lilith-project/lilith-hw-design/Proof of concept/Manufacturing/Lilith-POC_BOM.xls

Sheet: Appro
Item | Reference | Part Name | Value | Color | Qty | Category | Supplier | Supplier Reference | Qty per unit | Unit Price (for a batch of 2) | Unit Price (for a batch of 100) | Price per board (for a batch of 2) | Price per board (for a batch of 100)
68 | S1 | SW-SMD-SMALL |  |  | 1 | JTAG/RS232 Debug | Digikey | 1.14002.0030000CT-ND |  | 3.25 | 2.5982 | 3.25 | 2.5982
1 | U8-9 | 74LVC1G125DCK |  |  | 2 | JTAG/RS232 Debug | Digikey | 296-11604-1-ND |  | 0.08 | 0.0378 | 0.16 | 0.0756
56 | R4 R22 | RES0603,1k5 | 1k5 |  | 2 | JTAG/RS232 Debug | Digikey | 311-1.5KGRCT-ND |  | 0.01 | 0.0048 | 0.02 | 0.0096
50 | R30 | RES0603,100k | 100k |  | 1 | CPU | Digikey | 311-100KGRCT-ND |  | 0.01 | 0.0048 | 0.01 | 0.0048
14 | C28 C49 C51 C27 C72 | CAP0402,100pF | 100pF |  | 5 | Arduino | Digikey | 311-1024-1-ND |  | 0.0059 | 0.0027 | 0.0295 | 0.0135
13 | C1-26 C65 | CAP0402,100pF | 100pF |  | 27 | CPU | Digikey | 311-1024-1-ND |  | 0.0059 | 0.0027 | 0.1593 | 0.0729
16 | C42-48 C73 | CAP0402,100pF | 100pF |  | 8 | Ethernet | Digikey | 311-1024-1-ND |  | 0.0059 | 0.0027 | 0.0472 | 0.0216
21 | C66 | CAP0402,100pF | 100pF |  | 1 | Ext Power Supply +5V | Digikey | 311-1024-1-ND |  | 0.0059 | 0.0027 | 0.0059 | 0.0027
18 | C54-62 C52-53 | CAP0402,100pF | 100pF |  | 11 | JTAG/RS232 Debug | Digikey | 311-1024-1-ND |  | 0.0059 | 0.0027 | 0.0649 | 0.0297
20 | C70 | CAP0402,100pF | 100pF |  | 1 | Power supply +1V8 | Digikey | 311-1024-1-ND |  | 0.0059 | 0.0027 | 0.0059 | 0.0027
19 | C68 | CAP0402,100pF | 100pF |  | 1 | Power supply +3V3 | Digikey | 311-1024-1-ND |  | 0.0059 | 0.0027 | 0.0059 | 0.0027
22 | C29 | CAP0402,100pF | 100pF |  | 1 | SD Card | Digikey | 311-1024-1-ND |  | 0.0059 | 0.0027 | 0.0059 | 0.0027
15 | C34-36 | CAP0402,100pF | 100pF |  | 3 | USB Device | Digikey | 311-1024-1-ND |  | 0.0059 | 0.0027 | 0.0177 | 0.0081
17 | C30-32 | CAP0402,100pF | 100pF |  | 3 | USB Host | Digikey | 311-1024-1-ND |  | 0.0059 | 0.0027 | 0.0177 | 0.0081
54 | R26-29 R24-25 R33-34 | RES0603,10k | 10k |  | 8 | CPU | Digikey | 311-10KGRCT-ND |  | 0.01 | 0.0027 | 0.08 | 0.0216
52 | R17 R19-21 | RES0603,10k | 10k |  | 4 | Ethernet | Digikey | 311-10KGRCT-ND |  | 0.01 | 0.0027 | 0.04 | 0.0108
53 | R23 R31-32 | RES0603,10k | 10k |  | 3 | JTAG/RS232 Debug | Digikey | 311-10KGRCT-ND |  | 0.01 | 0.0027 | 0.03 | 0.0081
51 | R5 | RES0603,10k | 10k |  | 1 | SD Card | Digikey | 311-10KGRCT-ND |  | 0.01 | 0.0027 | 0.01 | 0.0027
25 | C64 | CAP0603,1nF | 1nF |  | 1 | CPU | Digikey | 311-1342-1-ND |  | 0.034 | 0.0158 | 0.034 | 0.0158
55 | R10 | RES0603,15k | 15k |  | 1 | USB Device | Digikey | 311-15KGRCT-ND |  | 0.01 | 0.0048 | 0.01 | 0.0048
58 | R36-37 | RES0603,220R | 220R |  | 2 | Arduino | Digikey | 311-220GRCT-ND |  | 0.01 | 0.0048 | 0.02 | 0.0096
57 | R18 | RES0603,220R | 220R |  | 1 | Ethernet | Digikey | 311-220GRCT-ND |  | 0.01 | 0.0048 | 0.01 | 0.0048
59 | R11 | RES0603,22k | 22k |  | 1 | USB Device | Digikey | 311-22KGRCT-ND |  | 0.01 | 0.0048 | 0.01 | 0.0048
60 | R1-2 | RES0603,27R | 27R |  | 2 | JTAG/RS232 Debug | Digikey | 311-27GRCT-ND |  | 0.01 | 0.0048 | 0.02 | 0.0096
62 | R8-9 | RES0603,39R | 39R |  | 2 | USB Device | Digikey | 311-39GRCT-ND |  | 0.01 | 0.0048 | 0.02 | 0.0096
61 | R6-7 | RES0603,39R | 39R |  | 2 | USB Host | Digikey | 311-39GRCT-ND |  | 0.01 | 0.0048 | 0.02 | 0.0096
64 | R35 | RES0603,470R | 470R |  | 1 | Ext Power Supply +5V | Digikey | 311-470GRCT-ND |  | 0.01 | 0.0048 | 0.01 | 0.0048
63 | R3 | RES0603,470R | 470R |  | 1 | JTAG/RS232 Debug | Digikey | 311-470GRCT-ND |  | 0.01 | 0.0048 | 0.01 | 0.0048
65 | R12-15 | RES0603,49R9 | 49R9 |  | 4 | Ethernet | Digikey | 311-49.9HRCT-ND |  | 0.014 | 0.0063 | 0.056 | 0.0252
66 | R16 | RES0603,6k49 | 6k49 |  | 1 | Ethernet | Digikey | 311-6.49KHRCT-ND |  | 0.014 | 0.0063 | 0.014 | 0.0063
41 | D2 | LED0603 |  | Green | 1 | Ethernet | Digikey | 475-1409-1-ND |  | 0.1 | 0.068 | 0.1 | 0.068
40 | D1 | LED0603 |  | Green | 1 | Ext Power Supply +5V | Digikey | 475-1409-1-ND |  | 0.1 | 0.068 | 0.1 | 0.068
42 | D3 | LED0603 |  | Red | 1 | Arduino | Digikey | 475-2512-1-ND |  | 0.11 | 0.0716 | 0.11 | 0.0716
43 | D4 | LED0603 |  | Yellow | 1 | Arduino | Digikey | 475-2558-1-ND |  | 0.11 | 0.0742 | 0.11 | 0.0742
24 | C63 | CAP0603,10nF | 10nF |  | 1 | CPU | Digikey | 478-1227-1-ND |  | 0.019 | 0.0088 | 0.019 | 0.0088
23 | C33 C37-38 | CAP0603,100nF | 100nF |  | 3 | Ethernet | Digikey | 478-1239-1-ND |  | 0.02 | 0.00764 | 0.06 | 0.02292
26 | C39-41 C50 | CAP-POL-1206,10uF | 10uF |  | 4 | Ethernet | Digikey | 493-2351-1-ND |  | 0.349 | 0.1344 | 1.396 | 0.5376
27 | C67 | CAP-POL-1206,10uF | 10uF |  | 1 | Ext Power Supply +5V | Digikey | 493-2351-1-ND |  | 0.349 | 0.1344 | 0.349 | 0.1344
29 | C71 | CAP-POL-1206,10uF | 10uF |  | 1 | Power supply +1V8 | Digikey | 493-2351-1-ND |  | 0.349 | 0.1344 | 0.349 | 0.1344
28 | C69 | CAP-POL-1206,10uF | 10uF |  | 1 | Power supply +3V3 | Digikey | 493-2351-1-ND |  | 0.349 | 0.1344 | 0.349 | 0.1344
38 | U11 | LD1117-3.3-SOT223 |  |  | 1 | Power supply +3V3 | Digikey | 497-1241-1-ND |  | 0.48 | 0.3059 | 0.48 | 0.3059
39 | U10 | LD1117-5-SOT223 |  |  | 1 | Ext Power Supply +5V | Digikey | 497-1243-1-ND |  | 0.48 | 0.3059 | 0.48 | 0.3059
37 | U12 | LD1117-1.8-SOT223 |  |  | 1 | Power supply +1V8 | Digikey | 497-7308-1-ND |  | 0.48 | 0.3059 | 0.48 | 0.3059
33 | F1 | FUSE-PTC-RESETTABLE,500 mA | 500 mA |  | 1 | USB Host | Digikey | 507-1489-1-ND |  | 0.28 | 0.1785 | 0.28 | 0.1785
49 | Y2 | OSC,6MHz | 6MHz |  | 1 | JTAG/RS232 Debug | Digikey | 535-11003-1-ND |  | 2.81 | 1.6875 | 2.81 | 1.6875
48 | Y1 | OSC,50MHz | 50MHz |  | 1 | Ethernet | Digikey | 535-11779-1-ND |  | 1.76 | 1.0575 | 1.76 | 1.0575
47 | Y3 | OSC,18.432MHz | 18.432MHz |  | 1 | CPU | Digikey | 535-9660-5-ND |  | 2.08 | 1.19 | 2.08 | 1.19
46 | U2 | MT48LC16M16A2 |  |  | 1 | CPU | Digikey | 557-1289-1-ND |  | 10.45 | 8.1864 | 10.45 | 8.1864
36 | U5 | KS8721_12 |  |  | 1 | Ethernet | Digikey | 576-2971-5-ND |  | 4.75 | 2.954 | 4.75 | 2.954
30 | L2-3 | FERRITE-0603,180R | 180R |  | 2 | Ethernet | Digikey | 587-1881-1-ND |  | 0.31 | 0.088 | 0.62 | 0.176
31 | L4 | FERRITE-0603,180R | 180R |  | 1 | JTAG/RS232 Debug | Digikey | 587-1881-1-ND |  | 0.31 | 0.088 | 0.31 | 0.088
32 | U4 | FT2232D |  |  | 1 | JTAG/RS232 Debug | Digikey | 768-1010-1-ND |  | 6.99 | 5.17 | 6.99 | 5.17
2 | U7 | 93C46B |  |  | 1 | JTAG/RS232 Debug | Digikey | 93C46BT-I/OTCT-ND |  | 0.32 | 0.19 | 0.32 | 0.19
12 | U1 | AT91SAM9XE128 |  |  | 1 | CPU | Digikey | AT91SAM9XE128-QU-ND |  | 19.87 | 11.088 | 19.87 | 11.088
35 | J8 | JACK_2.1MM |  |  | 1 | Ext Power Supply +5V | Digikey | CP-102A-ND |  | 0.92 | 0.4324 | 0.92 | 0.4324
9 | J6 | ARDUINO_XIOH |  |  | 1 | Arduino | Digikey | ED10529-ND | 2.5 | 0.45 | 0.322 | 0.18 | 0.1288
10 | J7 | ARDUINO_XIOL |  |  | 1 | Arduino | Digikey | ED10529-ND | 2.5 | 0.45 | 0.322 | 0.18 | 0.1288
11 | J15 | ARDUINO_XIO_POWER |  |  | 1 | Arduino | Digikey | ED10529-ND | 10 | 0.45 | 0.322 | 0.045 | 0.0322
70 | J10 | USBB |  |  | 1 | USB Device | Digikey | ED2983-ND |  | 0.54 | 0.34 | 0.54 | 0.34
69 | J9 | USBA |  |  | 1 | USB Host | Digikey | ED2989-ND |  | 0.45 | 0.28 | 0.45 | 0.28
71 | J12 | USBB-MINI |  |  | 1 | JTAG/RS232 Debug | Digikey | ED2992CT-ND |  | 0.68 | 0.546 | 0.68 | 0.546
45 | J13 | MICROSD |  |  | 1 | SD Card | Digikey | HR1972CT-ND |  | 1.79 | 1.1 | 1.79 | 1.1
44 | U3 U6 | MCP3008 |  |  | 2 | Arduino | Digikey | MAX11602EEE+-ND |  | 3.52 | 1.887 | 7.04 | 3.774
3 | J5 | ARDUINO_ADCH |  |  | 1 | Arduino | Digikey | S1012EC-40-ND | 5 | 0.51 | 0.378 | 0.102 | 0.0756
4 | J4 | ARDUINO_ADCL |  |  | 1 | Arduino | Digikey | S1012EC-40-ND | 5 | 0.51 | 0.378 | 0.102 | 0.0756
5 | J3 | ARDUINO_COM |  |  | 1 | Arduino | Digikey | S1012EC-40-ND | 5 | 0.51 | 0.378 | 0.102 | 0.0756
6 | J14 | ARDUINO_POWER |  |  | 1 | Arduino | Digikey | S1012EC-40-ND | 6.666666667 | 0.51 | 0.378 | 0.0765 | 0.0567
7 | J1 | ARDUINO_PWMH |  |  | 1 | Arduino | Digikey | S1012EC-40-ND | 5 | 0.51 | 0.378 | 0.102 | 0.0756
8 | J2 | ARDUINO_PWML |  |  | 1 | Arduino | Digikey | S1012EC-40-ND | 5 | 0.51 | 0.378 | 0.102 | 0.0756
67 | J11 | RJ45-MAGNETIC |  |  | 1 | Ethernet | Digikey | S9399-ND |  | 2.89 | 1.8887 | 2.89 | 1.8887
34 | X1-4 | HOLE-3MM |  |  | 4 |  |  |  |  |  |  | 0 | 0
 |  |  |  |  |  |  |  |  |  | Price per board (for a batch of 100) |  |  | 46.22932
 |  |  |  |  |  |  |  |  |  | Price per board (for a batch of 2) |  | 74.1174

Sheet: Assembly
Reference | Part Name | Value | Color | Supplier Reference
U8 | 74LVC1G125DCK |  |  | 296-11604-1-ND
U9 | 74LVC1G125DCK |  |  | 296-11604-1-ND
U7 | 93C46B |  |  | 93C46BT-I/OTCT-ND
J5 | ARDUINO_ADCH |  |  | S1012EC-40-ND
J4 | ARDUINO_ADCL |  |  | S1012EC-40-ND
J3 | ARDUINO_COM |  |  | S1012EC-40-ND
J14 | ARDUINO_POWER |  |  | S1012EC-40-ND
J1 | ARDUINO_PWMH |  |  | S1012EC-40-ND
J2 | ARDUINO_PWML |  |  | S1012EC-40-ND
J6 | ARDUINO_XIOH |  |  | ED10529-ND
J7 | ARDUINO_XIOL |  |  | ED10529-ND
J15 | ARDUINO_XIO_POWER |  |  | ED10529-ND
U1 | AT91SAM9XE128 |  |  | AT91SAM9XE128-QU-ND
C1 | CAP0402,100pF | 100pF |  | 311-1024-1-ND
C2 | CAP0402,100pF | 100pF |  | 311-1024-1-ND
C3 | CAP0402,100pF | 100pF |  | 311-1024-1-ND
C4 | CAP0402,100pF | 100pF |  | 311-1024-1-ND
C5 | CAP0402,100pF | 100pF |  | 311-1024-1-ND
C6 | CAP0402,100pF | 100pF |  | 311-1024-1-ND
C7 | CAP0402,100pF | 100pF |  | 311-1024-1-ND
C8 | CAP0402,100pF | 100pF |  | 311-1024-1-ND
C9 | CAP0402,100pF | 100pF |  | 311-1024-1-ND
C10 | CAP0402,100pF | 100pF |  | 311-1024-1-ND
C11 | CAP0402,100pF | 100pF |  | 311-1024-1-ND
C12 | CAP0402,100pF | 100pF |  | 311-1024-1-ND
C13 | CAP0402,100pF | 100pF |  | 311-1024-1-ND
C14 | CAP0402,100pF | 100pF |  | 311-1024-1-ND
C15 | CAP0402,100pF | 100pF |  | 311-1024-1-ND
C16 | CAP0402,100pF | 100pF |  | 311-1024-1-ND
C17 | CAP0402,100pF | 100pF |  | 311-1024-1-ND
C18 | CAP0402,100pF | 100pF |  | 311-1024-1-ND
C19 | CAP0402,100pF | 100pF |  | 311-1024-1-ND
C20 | CAP0402,100pF | 100pF |  | 311-1024-1-ND
C21 | CAP0402,100pF | 100pF |  | 311-1024-1-ND
C22 | CAP0402,100pF | 100pF |  | 311-1024-1-ND
C23 | CAP0402,100pF | 100pF |  | 311-1024-1-ND
C24 | CAP0402,100pF | 100pF |  | 311-1024-1-ND
C25 | CAP0402,100pF | 100pF |  | 311-1024-1-ND
C26 | CAP0402,100pF | 100pF |  | 311-1024-1-ND
C27 | CAP0402,100pF | 100pF |  | 311-1024-1-ND
C28 | CAP0402,100pF | 100pF |  | 311-1024-1-ND
C29 | CAP0402,100pF | 100pF |  | 311-1024-1-ND
C30 | CAP0402,100pF | 100pF |  | 311-1024-1-ND
C31 | CAP0402,100pF | 100pF |  | 311-1024-1-ND
C32 | CAP0402,100pF | 100pF |  | 311-1024-1-ND
C34 | CAP0402,100pF | 100pF |  | 311-1024-1-ND
C35 | CAP0402,100pF | 100pF |  | 311-1024-1-ND
C36 | CAP0402,100pF | 100pF |  | 311-1024-1-ND
C42 | CAP0402,100pF | 100pF |  | 311-1024-1-ND
C43 | CAP0402,100pF | 100pF |  | 311-1024-1-ND
C44 | CAP0402,100pF | 100pF |  | 311-1024-1-ND
C45 | CAP0402,100pF | 100pF |  | 311-1024-1-ND
C46 | CAP0402,100pF | 100pF |  | 311-1024-1-ND
C47 | CAP0402,100pF | 100pF |  | 311-1024-1-ND
C48 | CAP0402,100pF | 100pF |  | 311-1024-1-ND
C49 | CAP0402,100pF | 100pF |  | 311-1024-1-ND
C51 | CAP0402,100pF | 100pF |  | 311-1024-1-ND
C52 | CAP0402,100pF | 100pF |  | 311-1024-1-ND
C53 | CAP0402,100pF | 100pF |  | 311-1024-1-ND
C54 | CAP0402,100pF | 100pF |  | 311-1024-1-ND
C55 | CAP0402,100pF | 100pF |  | 311-1024-1-ND
C56 | CAP0402,100pF | 100pF |  | 311-1024-1-ND
C57 | CAP0402,100pF | 100pF |  | 311-1024-1-ND
C58 | CAP0402,100pF | 100pF |  | 311-1024-1-ND
C59 | CAP0402,100pF | 100pF |  | 311-1024-1-ND
C60 | CAP0402,100pF | 100pF |  | 311-1024-1-ND
C61 | CAP0402,100pF | 100pF |  | 311-1024-1-ND
C62 | CAP0402,100pF | 100pF |  | 311-1024-1-ND
C65 | CAP0402,100pF | 100pF |  | 311-1024-1-ND
C66 | CAP0402,100pF | 100pF |  | 311-1024-1-ND
C68 | CAP0402,100pF | 100pF |  | 311-1024-1-ND
C70 | CAP0402,100pF | 100pF |  | 311-1024-1-ND
C72 | CAP0402,100pF | 100pF |  | 311-1024-1-ND
C73 | CAP0402,100pF | 100pF |  | 311-1024-1-ND
C74 | CAP0402,100pF | 100pF |  | 311-1024-1-ND
C33 | CAP0603,100nF | 100nF |  | 478-1239-1-ND
C37 | CAP0603,100nF | 100nF |  | 478-1239-1-ND
C38 | CAP0603,100nF | 100nF |  | 478-1239-1-ND
C63 | CAP0603,10nF | 10nF |  | 478-1227-1-ND
C64 | CAP0603,1nF | 1nF |  | 311-1342-1-ND
C39 | CAP-POL-1206,10uF | 10uF |  | 493-2351-1-ND
C40 | CAP-POL-1206,10uF | 10uF |  | 493-2351-1-ND
C41 | CAP-POL-1206,10uF | 10uF |  | 493-2351-1-ND
C50 | CAP-POL-1206,10uF | 10uF |  | 493-2351-1-ND
C67 | CAP-POL-1206,10uF | 10uF |  | 493-2351-1-ND
C69 | CAP-POL-1206,10uF | 10uF |  | 493-2351-1-ND
C71 | CAP-POL-1206,10uF | 10uF |  | 493-2351-1-ND
L2 | FERRITE-0603,180R | 180R |  | 587-1881-1-ND
L3 | FERRITE-0603,180R | 180R |  | 587-1881-1-ND
L4 | FERRITE-0603,180R | 180R |  | 587-1881-1-ND
U4 | FT2232D |  |  | 768-1010-1-ND
F1 | FUSE-PTC-RESETTABLE,500 mA | 500 mA |  | 507-1489-1-ND
X1 | HOLE-3MM
X2 | HOLE-3MM
X3 | HOLE-3MM
X4 | HOLE-3MM
J8 | JACK_2.1MM |  |  | CP-102A-ND
U5 | KS8721_12 |  |  | 576-2971-5-ND
U12 | LD1117-1.8-SOT223 |  |  | 497-7308-1-ND
U11 | LD1117-3.3-SOT223 |  |  | 497-1241-1-ND
U10 | LD1117-5-SOT223 |  |  | 497-1243-1-ND
D1 | LED0603 |  | Green | 475-1409-1-ND
D2 | LED0603 |  | Green | 475-1409-1-ND
D3 | LED0603 |  | Red | 475-2512-1-ND
D4 | LED0603 |  | Yellow | 475-2558-1-ND
U3 | MCP3008 |  |  | MAX11602EEE+-ND
U6 | MCP3008 |  |  | MAX11602EEE+-ND
J13 | MICROSD |  |  | HR1972CT-ND
U2 | MT48LC16M16A2 |  |  | 557-1289-1-ND
Y3 | OSC,18.432MHz | 18.432MHz |  | 535-9660-5-ND
Y1 | OSC,50MHz | 50MHz |  | 535-11779-1-ND
Y2 | OSC,6MHz | 6MHz |  | 535-11003-1-ND
R30 | RES0603,100k | 100k |  | 311-100KGRCT-ND
R5 | RES0603,10k | 10k |  | 311-10KGRCT-ND
R17 | RES0603,10k | 10k |  | 311-10KGRCT-ND
R19 | RES0603,10k | 10k |  | 311-10KGRCT-ND
R20 | RES0603,10k | 10k |  | 311-10KGRCT-ND
R21 | RES0603,10k | 10k |  | 311-10KGRCT-ND
R23 | RES0603,10k | 10k |  | 311-10KGRCT-ND
R24 | RES0603,10k | 10k |  | 311-10KGRCT-ND
R25 | RES0603,10k | 10k |  | 311-10KGRCT-ND
R26 | RES0603,10k | 10k |  | 311-10KGRCT-ND
R27 | RES0603,10k | 10k |  | 311-10KGRCT-ND
R28 | RES0603,10k | 10k |  | 311-10KGRCT-ND
R29 | RES0603,10k | 10k |  | 311-10KGRCT-ND
R31 | RES0603,10k | 10k |  | 311-10KGRCT-ND
R32 | RES0603,10k | 10k |  | 311-10KGRCT-ND
R33 | RES0603,10k | 10k |  | 311-10KGRCT-ND
R34 | RES0603,10k | 10k |  | 311-10KGRCT-ND
R10 | RES0603,15k | 15k |  | 311-15KGRCT-ND
R4 | RES0603,1k5 | 1k5 |  | 311-1.5KGRCT-ND
R22 | RES0603,1k5 | 1k5 |  | 311-1.5KGRCT-ND
R18 | RES0603,220R | 220R |  | 311-220GRCT-ND
R36 | RES0603,220R | 220R |  | 311-220GRCT-ND
R37 | RES0603,220R | 220R |  | 311-220GRCT-ND
R11 | RES0603,22k | 22k |  | 311-22KGRCT-ND
R1 | RES0603,27R | 27R |  | 311-27GRCT-ND
R2 | RES0603,27R | 27R |  | 311-27GRCT-ND
R6 | RES0603,39R | 39R |  | 311-39GRCT-ND
R7 | RES0603,39R | 39R |  | 311-39GRCT-ND
R8 | RES0603,39R | 39R |  | 311-39GRCT-ND
R9 | RES0603,39R | 39R |  | 311-39GRCT-ND
R3 | RES0603,470R | 470R |  | 311-470GRCT-ND
R35 | RES0603,470R | 470R |  | 311-470GRCT-ND
R12 | RES0603,49R9 | 49R9 |  | 311-49.9HRCT-ND
R13 | RES0603,49R9 | 49R9 |  | 311-49.9HRCT-ND
R14 | RES0603,49R9 | 49R9 |  | 311-49.9HRCT-ND
R15 | RES0603,49R9 | 49R9 |  | 311-49.9HRCT-ND
R16 | RES0603,6k49 | 6k49 |  | 311-6.49KHRCT-ND
J11 | RJ45-MAGNETIC |  |  | S9399-ND
S1 | SW-SMD-SMALL |  |  | 1.14002.0030000CT-ND
J9 | USBA |  |  | ED2989-ND
J10 | USBB |  |  | ED2983-ND
J12 | USBB-MINI |  |  | ED2992CT-ND

Sheet: 2012-04-22-Lilit-rev1A
Index | Quantity | Part Number | Description | Customer Reference | Backorder Quantity | Unit Price USD | Extended Price USD
1 | 2 | 1.14002.0030000CT-ND | SWITCH PUSH SPST-NO 0.1A 35V |  | 0 | 3.25 | $6.50
2 | 10 | 311-1.5KGRCT-ND | RES 1.5K OHM 1/10W 5% 0603 SMD |  | 0 | 0.01 | $0.10
3 | 10 | 311-100KGRCT-ND | RES 100K OHM 1/10W 5% 0603 SMD |  | 0 | 0.01 | $0.10
4 | 140 | 311-1024-1-ND | CAP CER 100PF 50V 5% NPO 0402 |  | 0 | 0.0059 | $0.83
5 | 40 | 311-10KGRCT-ND | RES 10K OHM 1/10W 5% 0603 SMD |  | 0 | 0.01 | $0.40
6 | 10 | 311-1342-1-ND | CAP CER 1000PF 25V 5% NPO 0603 |  | 0 | 0.034 | $0.34
7 | 10 | 311-15KGRCT-ND | RES 15K OHM 1/10W 5% 0603 SMD |  | 0 | 0.01 | $0.10
8 | 10 | 311-220GRCT-ND | RES 220 OHM 1/10W 5% 0603 SMD |  | 0 | 0.01 | $0.10
9 | 10 | 311-22KGRCT-ND | RES 22K OHM 1/10W 5% 0603 SMD |  | 0 | 0.01 | $0.10
10 | 10 | 311-27GRCT-ND | RES 27 OHM 1/10W 5% 0603 SMD |  | 0 | 0.01 | $0.10
11 | 10 | 311-39GRCT-ND | RES 39 OHM 1/10W 5% 0603 SMD |  | 0 | 0.01 | $0.10
12 | 10 | 311-470GRCT-ND | RES 470 OHM 1/10W 5% 0603 SMD |  | 0 | 0.01 | $0.10
13 | 10 | 311-49.9HRCT-ND | RES 49.9 OHM 1/10W 1% 0603 SMD |  | 0 | 0.014 | $0.14
14 | 10 | 311-6.49KHRCT-ND | RES 6.49K OHM 1/10W 1% 0603 SMD |  | 0 | 0.014 | $0.14
15 | 4 | 475-1409-1-ND | LED CHIPLED 570NM GREEN 0603 SMD |  | 0 | 0.1 | $0.40
16 | 2 | 475-2512-1-ND | LED CHIPLED 633NM RED 0603 SMD |  | 0 | 0.11 | $0.22
17 | 2 | 475-2558-1-ND | LED CHIPLED 587NM YLW 0603 SMD |  | 0 | 0.11 | $0.22
18 | 10 | 478-1227-1-ND | CAP CER 10000PF 50V 10% X7R 0603 |  | 0 | 0.019 | $0.19
19 | 10 | 478-1239-1-ND | CAP CER 0.1UF 16V 10% X7R 0603 |  | 0 | 0.02 | $0.20
20 | 14 | 493-2351-1-ND | CAP TANT 10UF 10V 20% 1206 |  | 0 | 0.349 | $4.89
21 | 2 | 497-1241-1-ND | IC REG LDO 3.3V 950MA SOT-223 |  | 0 | 0.48 | $0.96
22 | 2 | 497-1243-1-ND | IC REG LDO 5V 950MA SOT-223 |  | 0 | 0.48 | $0.96
23 | 2 | 497-7308-1-ND | IC REG LDO 1.8V 950MA SOT-223 |  | 0 | 0.48 | $0.96
24 | 2 | 507-1489-1-ND | PTC RESTTBLE 0.50A 16V CHIP 1210 |  | 0 | 0.28 | $0.56
25 | 2 | 535-11003-1-ND | OSC MEMS 6.000 MHZ SMD |  | 0 | 2.81 | $5.62
26 | 2 | 535-11779-1-ND | OSC MEMS 50.000 MHZ SMD |  | 0 | 1.76 | $3.52
27 | 2 | 535-9660-5-ND | OSC MEMS 18.432 MHZ 3.0V SMD |  | 0 | 2.08 | $4.16
28 | 2 | 557-1289-1-ND | IC SDRAM 256MBIT 133MHZ 54TSOP |  | 0 | 10.45 | $20.90
29 | 2 | 576-2971-5-ND | IC ETHERNET PHY IND 48-TQFP |  | 0 | 4.75 | $9.50
30 | 6 | 587-1881-1-ND | FERRITE BEAD 180 OHM 0603 |  | 0 | 0.31 | $1.86
31 | 2 | 768-1010-1-ND | IC USB FS DUAL UART/FIFO 48-LQFP |  | 0 | 6.99 | $13.98
32 | 2 | 93C46BT-I/OTCT-ND | IC EEPROM 1KBIT 2MHZ SOT23-6 |  | 0 | 0.32 | $0.64
33 | 2 | AT91SAM9XE128-QU-ND | MCU ARM9 128K FLASH 208-PQFP |  | 0 | 19.87 | $39.74
34 | 2 | CP-102A-ND | CONN JACK POWER 2.1MM PCB |  | 0 | 0.92 | $1.84
35 | 2 | ED10529-ND | CONN HEADER VERT 40POS GOLD |  | 0 | 0.45 | $0.90
36 | 2 | ED2983-ND | CONN USB TYPE B R/A BLACK |  | 0 | 0.54 | $1.08
37 | 2 | ED2992CT-ND | CONN USB MINI B R/A SMD |  | 0 | 0.68 | $1.36
38 | 2 | HR1972CT-ND | CONN MICRO SD R/A HING TYPE SMD |  | 0 | 1.79 | $3.58
39 | 4 | MAX11602EEE+-ND | IC ADC SERIAL 8BIT 8CH 16-QSOP |  | 0 | 3.52 | $14.08
40 | 3 | S1012EC-40-ND | CONN HEADER .100" SNGL STR 40POS |  | 0 | 0.51 | $1.53
41 | 2 | S9399-ND | CONN MOD JACK 8-8 10/100 R/A PCB |  | 0 | 2.89 | $5.78
42 | 4 | 296-19721-1-ND | IC BUS BUFF TRI-ST N-INV SC705 |  | 0 | 0.64 | $2.56
43 | 2 | ED2990-ND | CONN USB TYPE A R/A BLACK |  | 0 | 0.45 | $0.90
 |  |  |  |  |  | Subtotal | $152.24
 |  |  |  |  |  | Shipping | $0.00
 |  |  |  |  |  | Total | $152.24
