lilith-project/lilith-hw-design/Proof of concept/Manufacturing/CAP0402-100pF-bottom.png

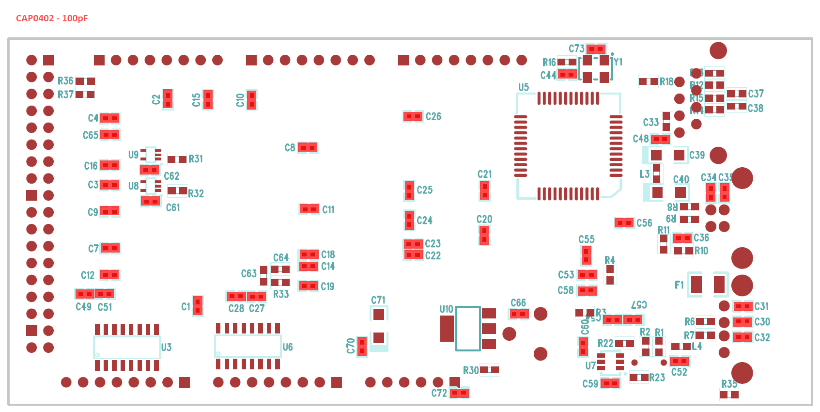
Proof of concept/Manufacturing/CAP0402-100pF-bottom.png
