lilith-project/lilith-hw-design/Proof of concept/Manufacturing/CAP-RES-General-bottom.png

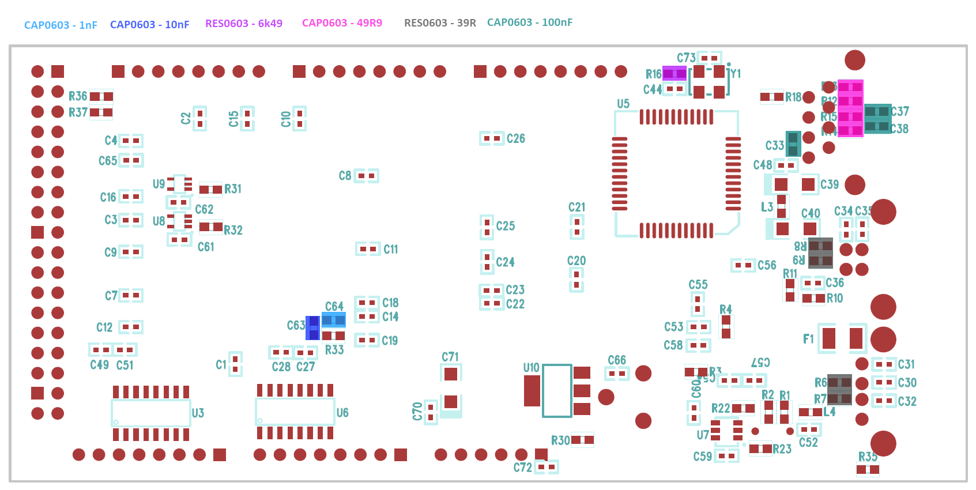
Proof of concept/Manufacturing/CAP-RES-General-bottom.png
