lilith-project/lilith-hw-design/Proof of concept/Manufacturing/RES0603-10k-bottom.png

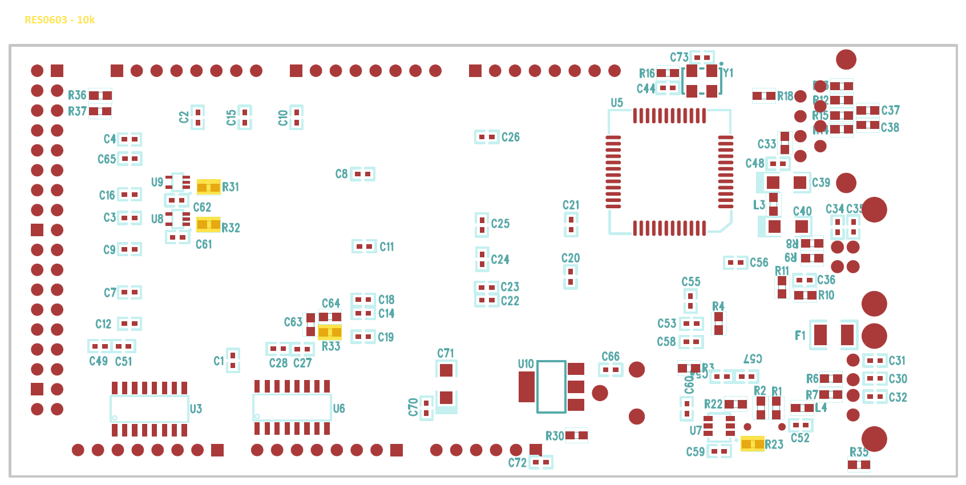
Proof of concept/Manufacturing/RES0603-10k-bottom.png
