lilith-project/lilith-hw-design/Proof of concept/Layout/Lilith-POC_Layout.pdf

# J15J15x1 J15x2 J15x3 J15x4

# J15J15x1 J15x2 J15x3 J15x4

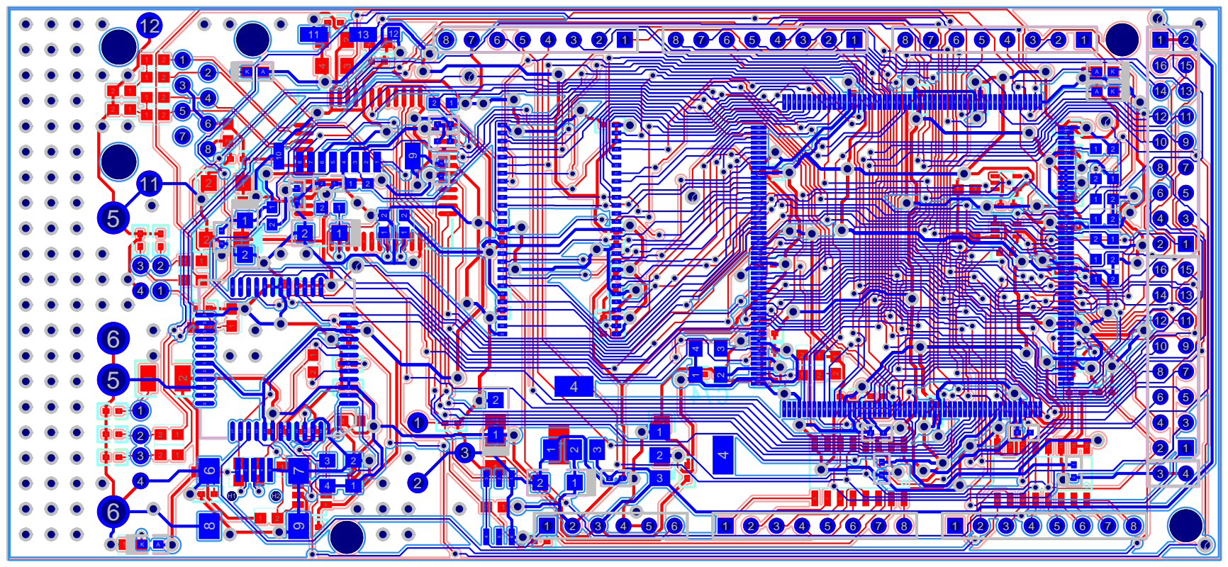
[picture p5: page 1]

# J15J15x1 J15x2 J15x3 J15x4

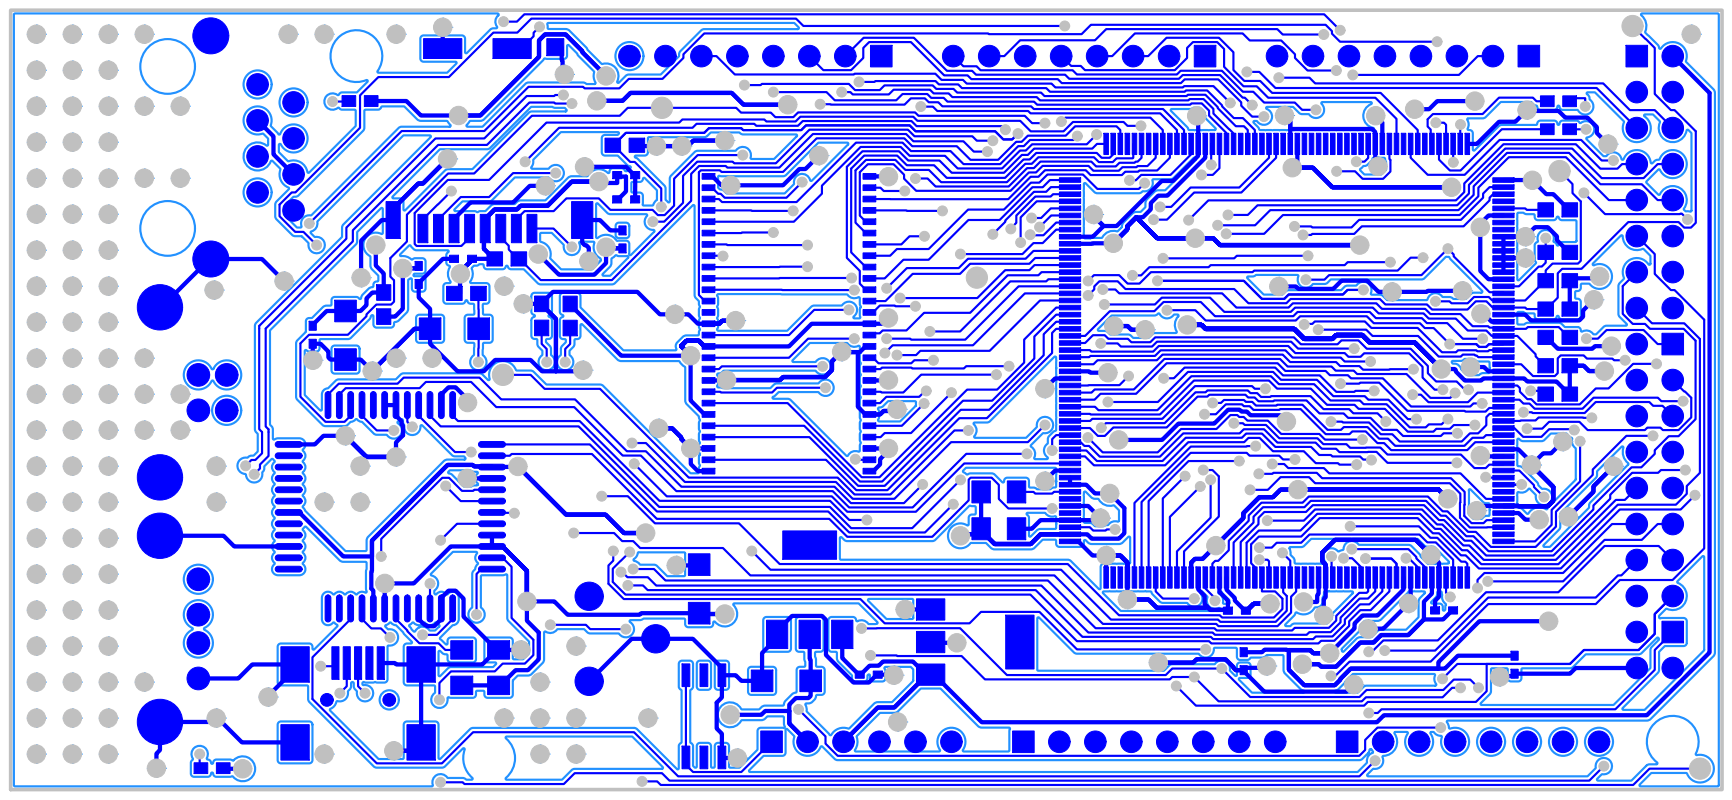
[picture p6: page 2]

# J15J15x1 J15x2 J15x3 J15x4

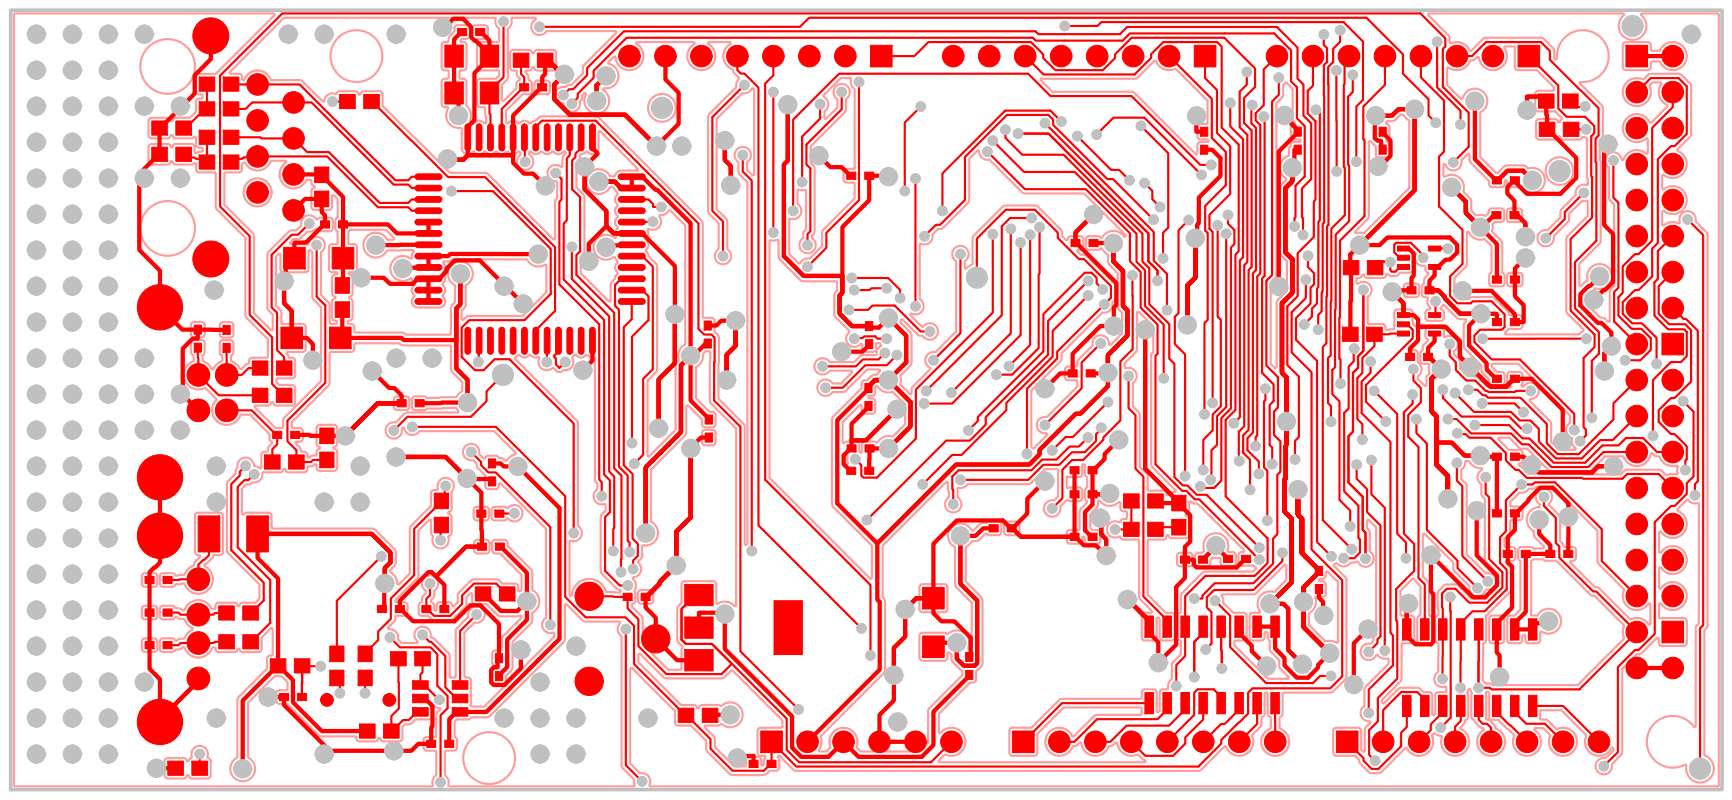
[picture p7: page 3]

J11

J15

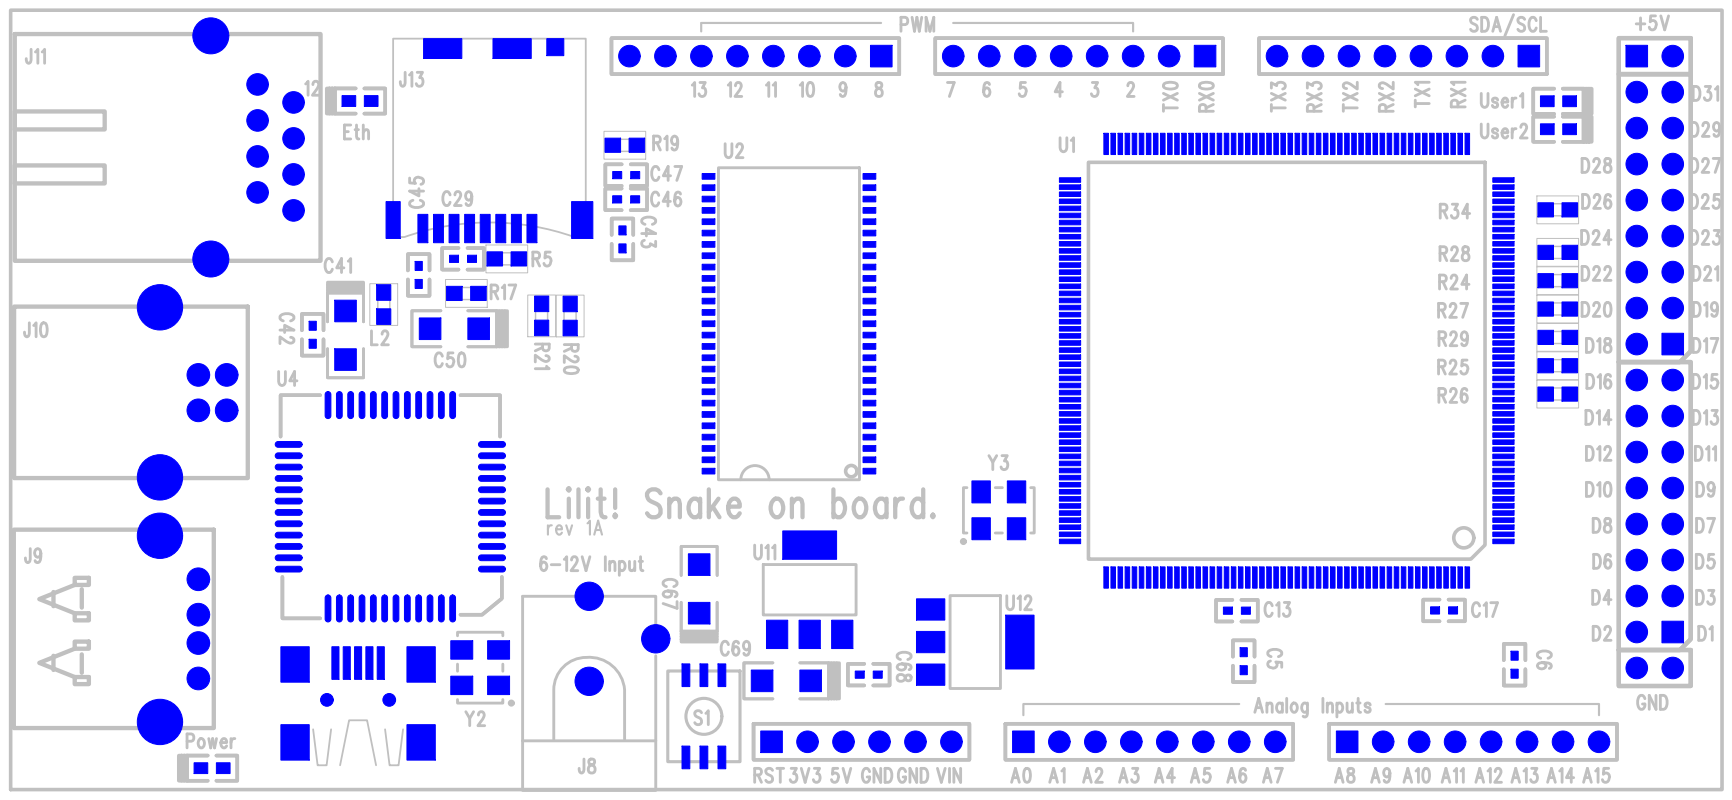
[picture p8: page 4]

Lilit! Snake on board.
rev 1A
6-12V Input

# J15J15x1 J15x2 J15x3 J15x4

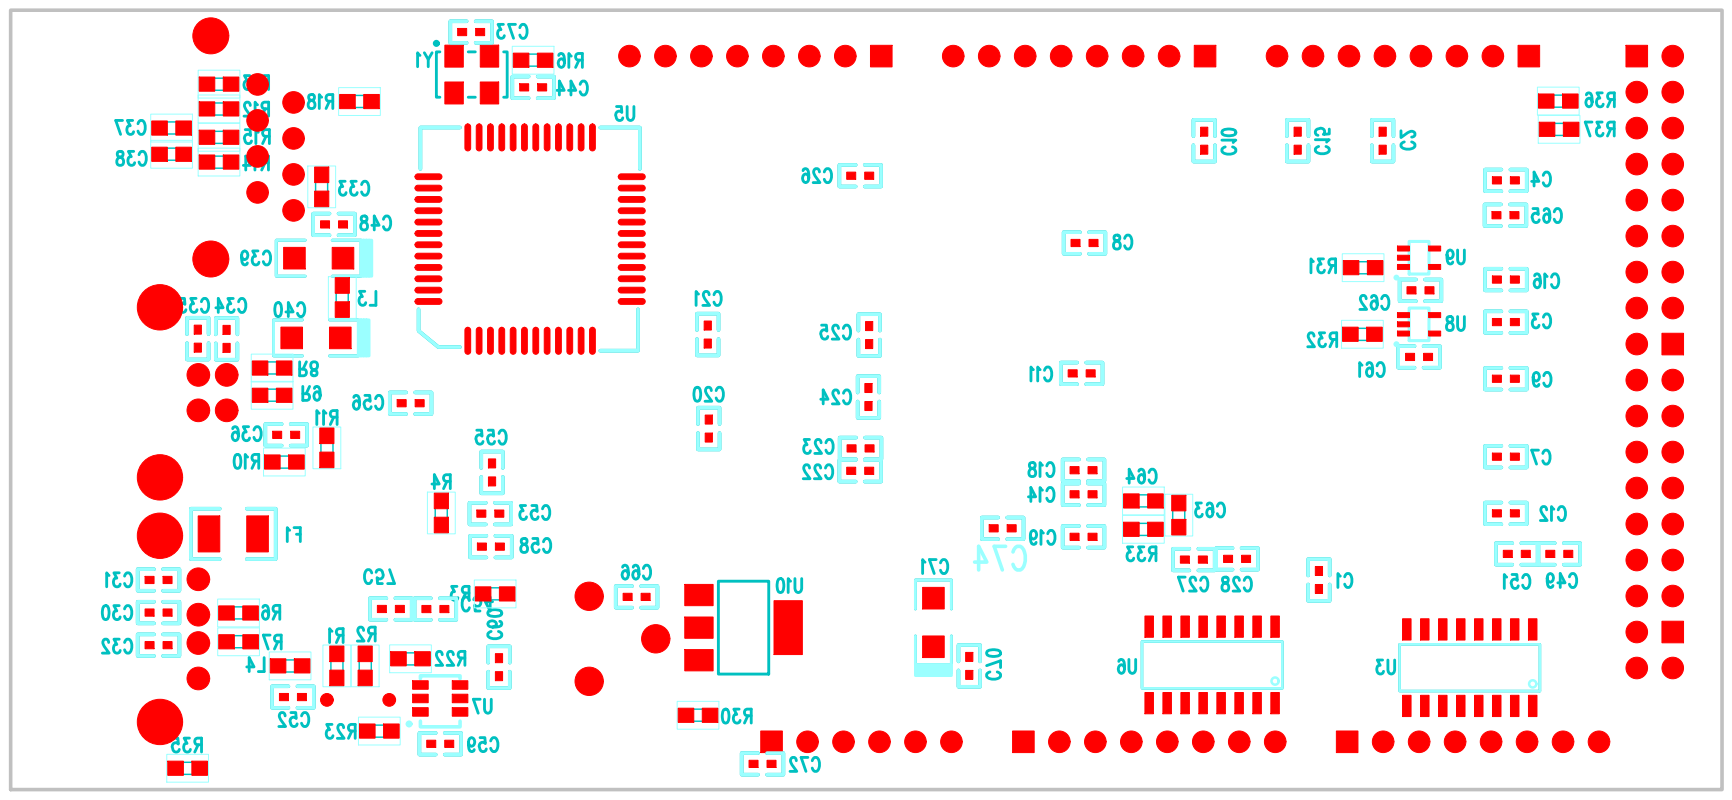
[picture p9: page 5]
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
