lilith-project/lilith-hw-design/Proof of concept/Schematics/Lilith-POC_Schematics.pdf

D

6 | 5 | 4 | 3 | 2 | 1

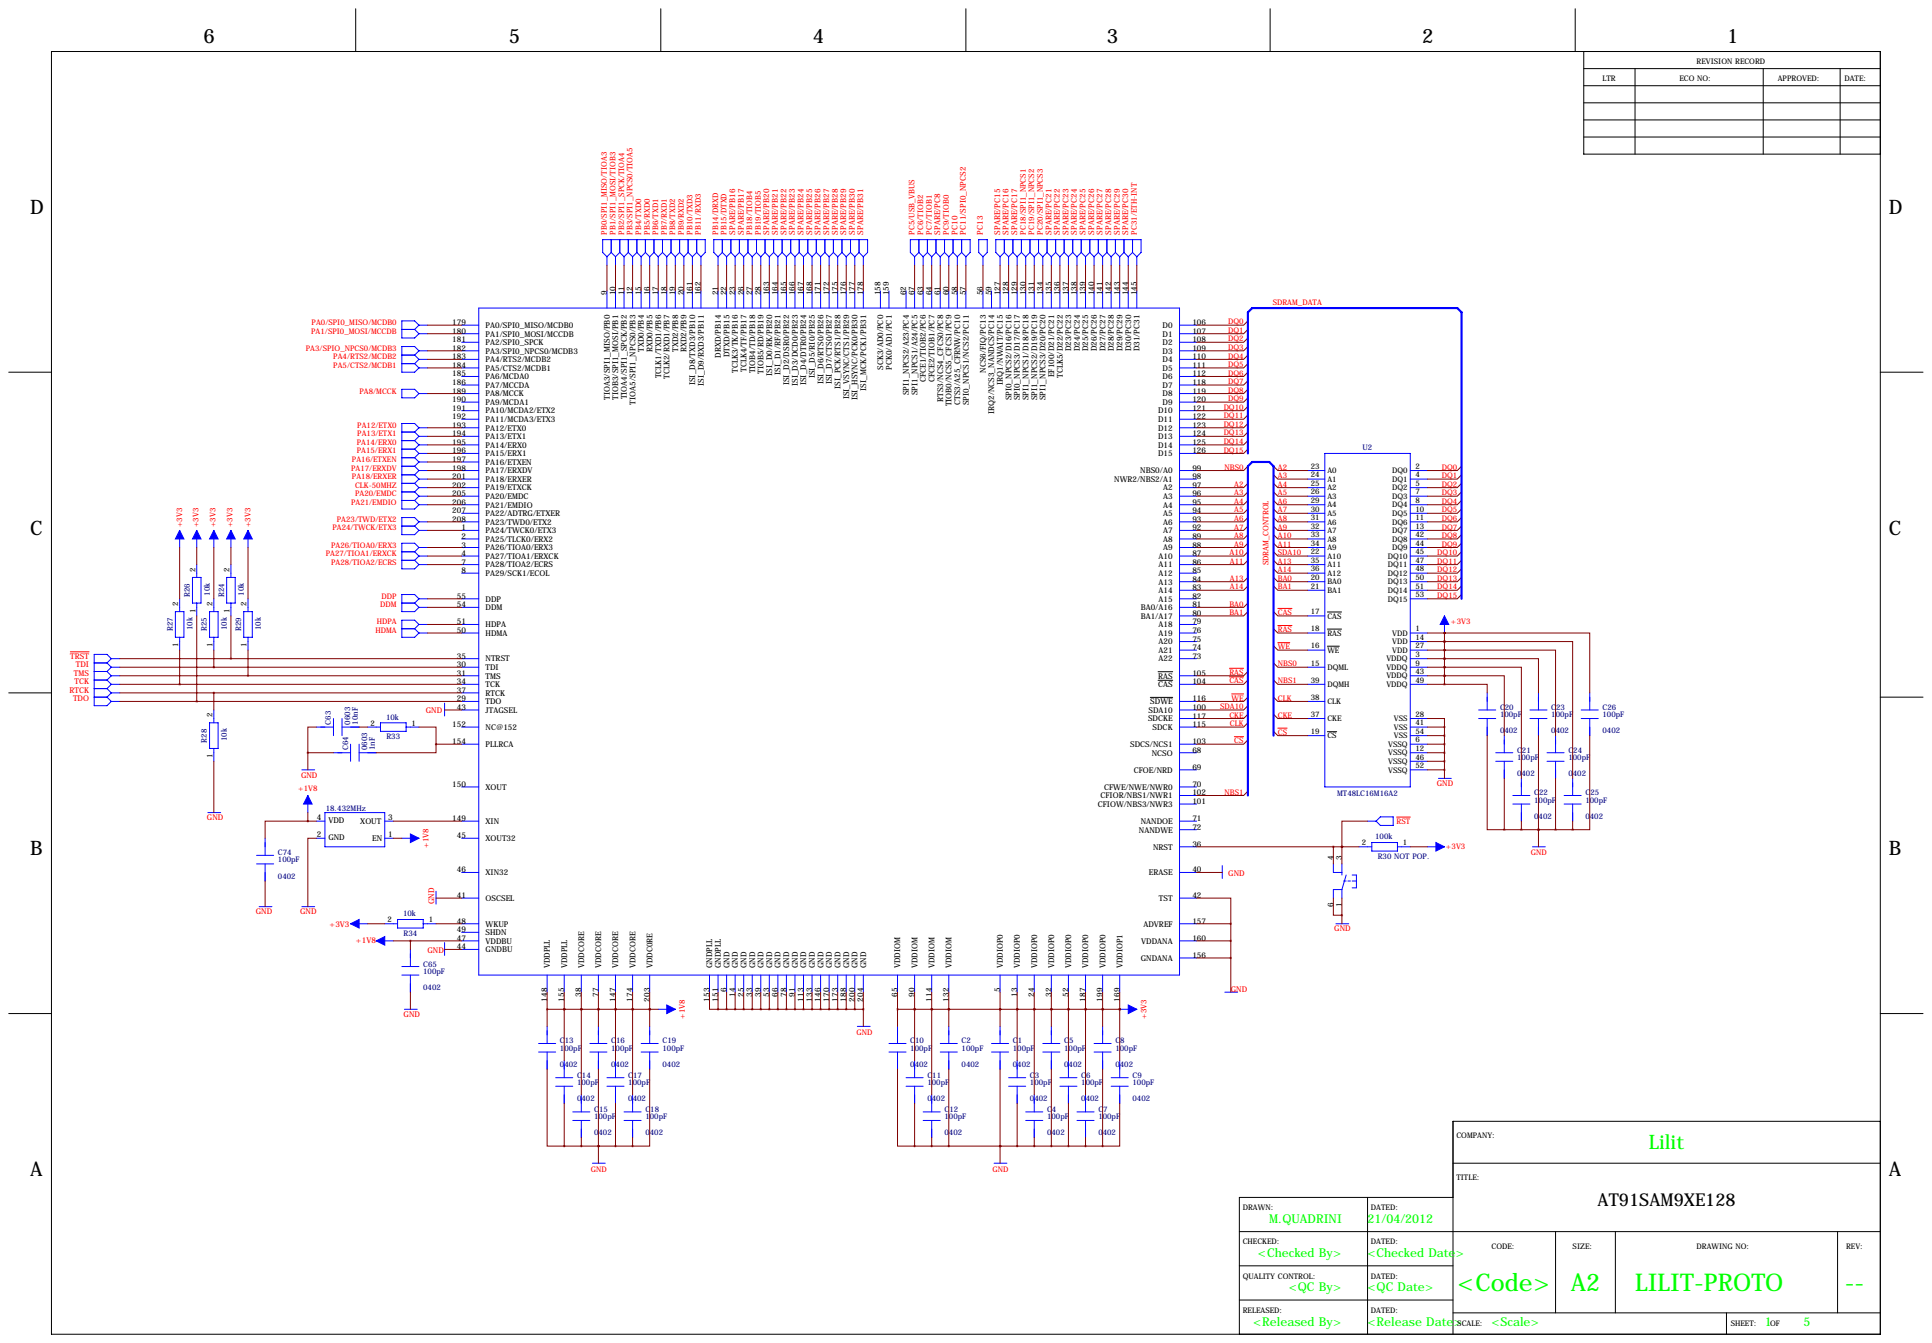
[picture p10: page 1]

REVISION RECORD

LTR | ECO NO: | APPROVED: | DATE:

DRAWN: M.QUADRINI | DATED: 21/04/2012

CHECKED: <Checked By> | DATED: <Checked Date> | CODE: <Code> | SIZE: A2 | DRAWING NO: LILIT-PROTO | REV: --

QUALITY CONTROL: <QC By> | DATED: <QC Date>

RELEASED: <Released By> | DATED:

<Scale> SCALE: | 1 5 SHEET: OF

D

D

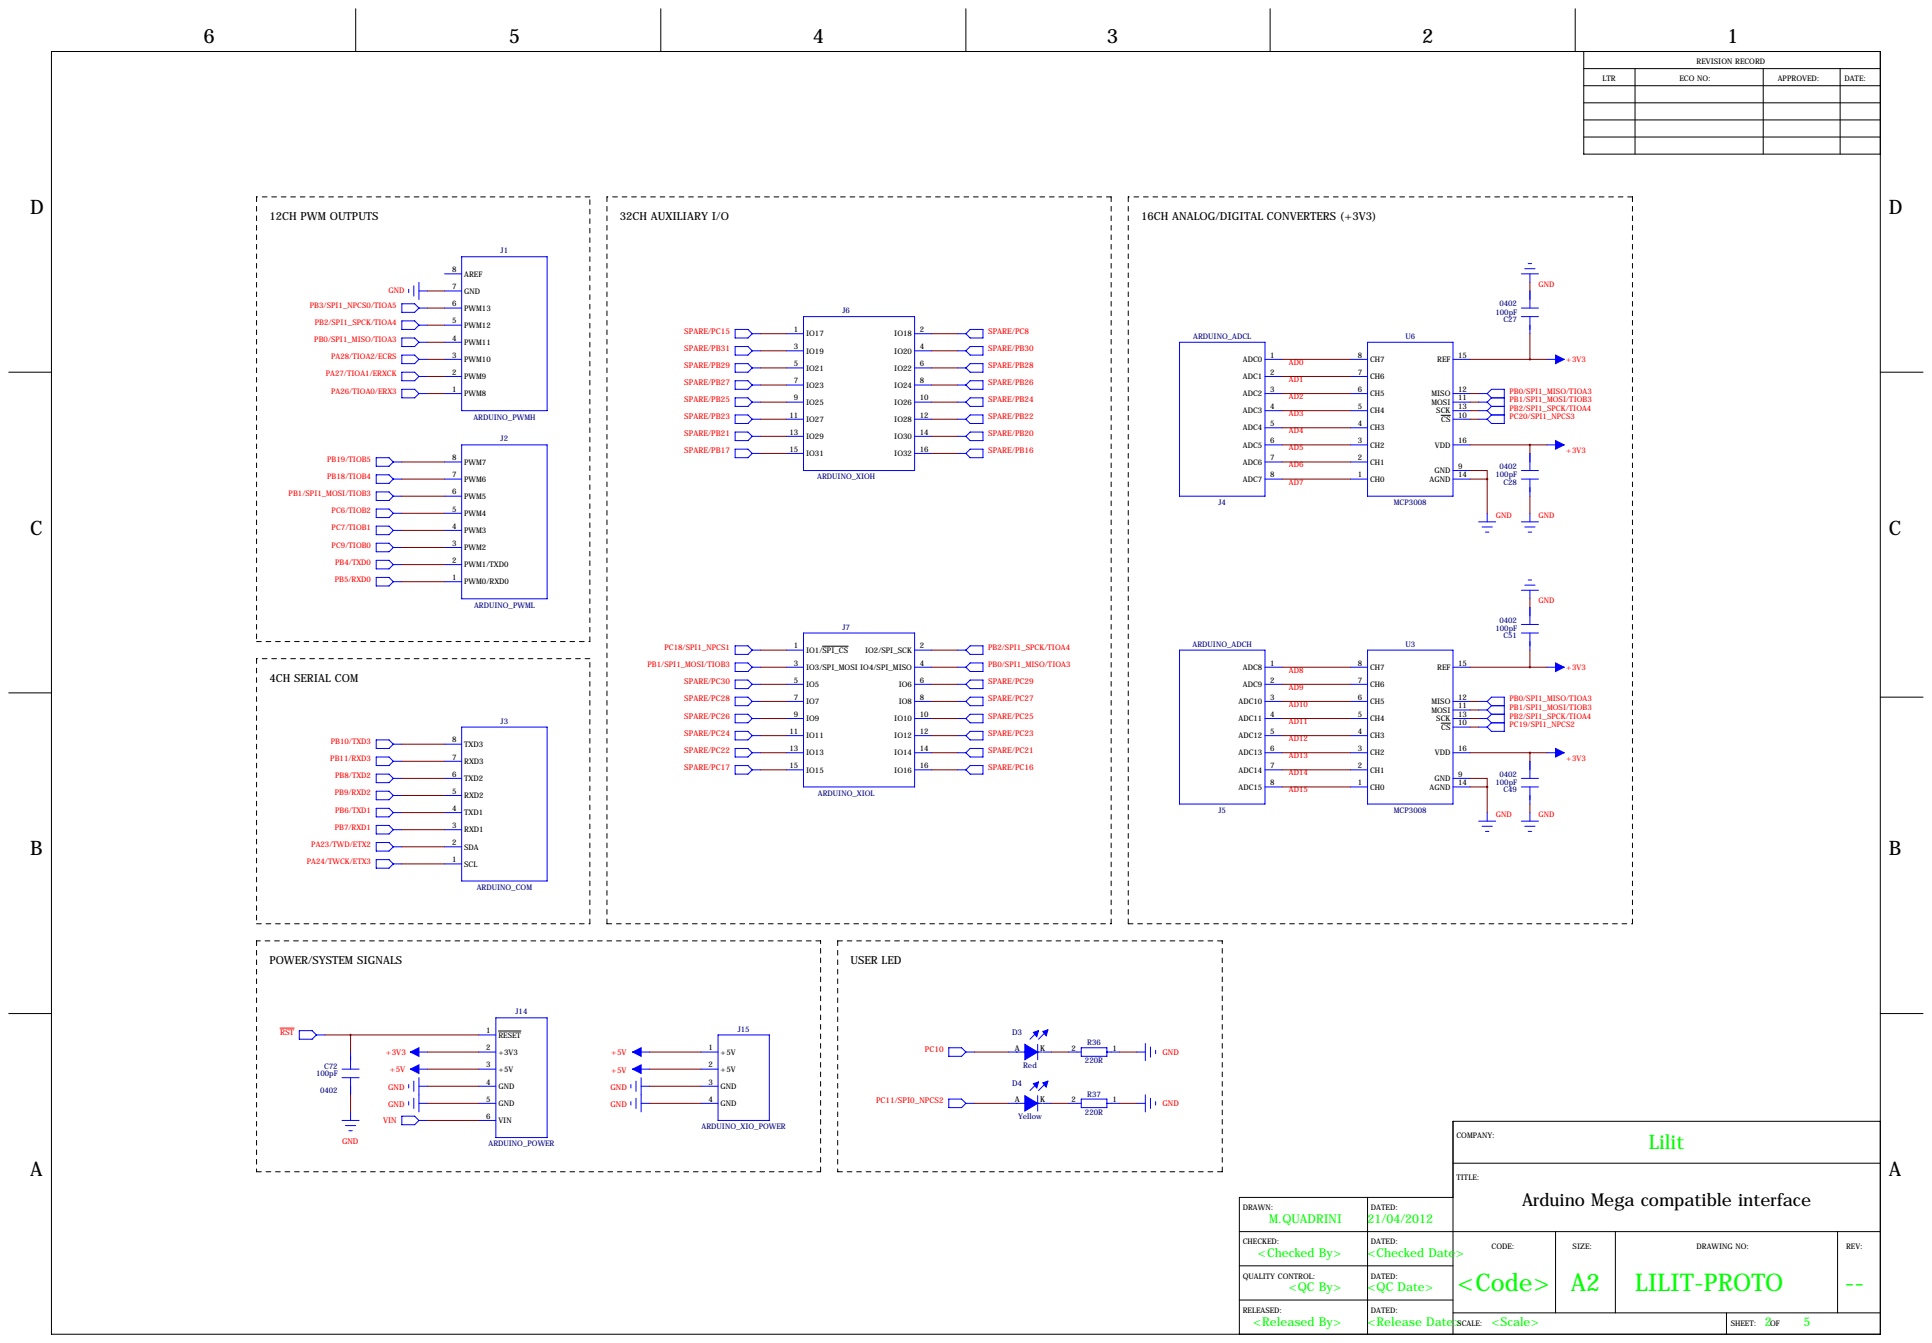
[picture p11: page 2]

Arduino Mega compatible interface

DRAWN: M.QUADRINI | DATED: 21/04/2012

CHECKED: <Checked By> | DATED: <Checked Date> | CODE: | SIZE: | DRAWING NO: | REV:

D

D

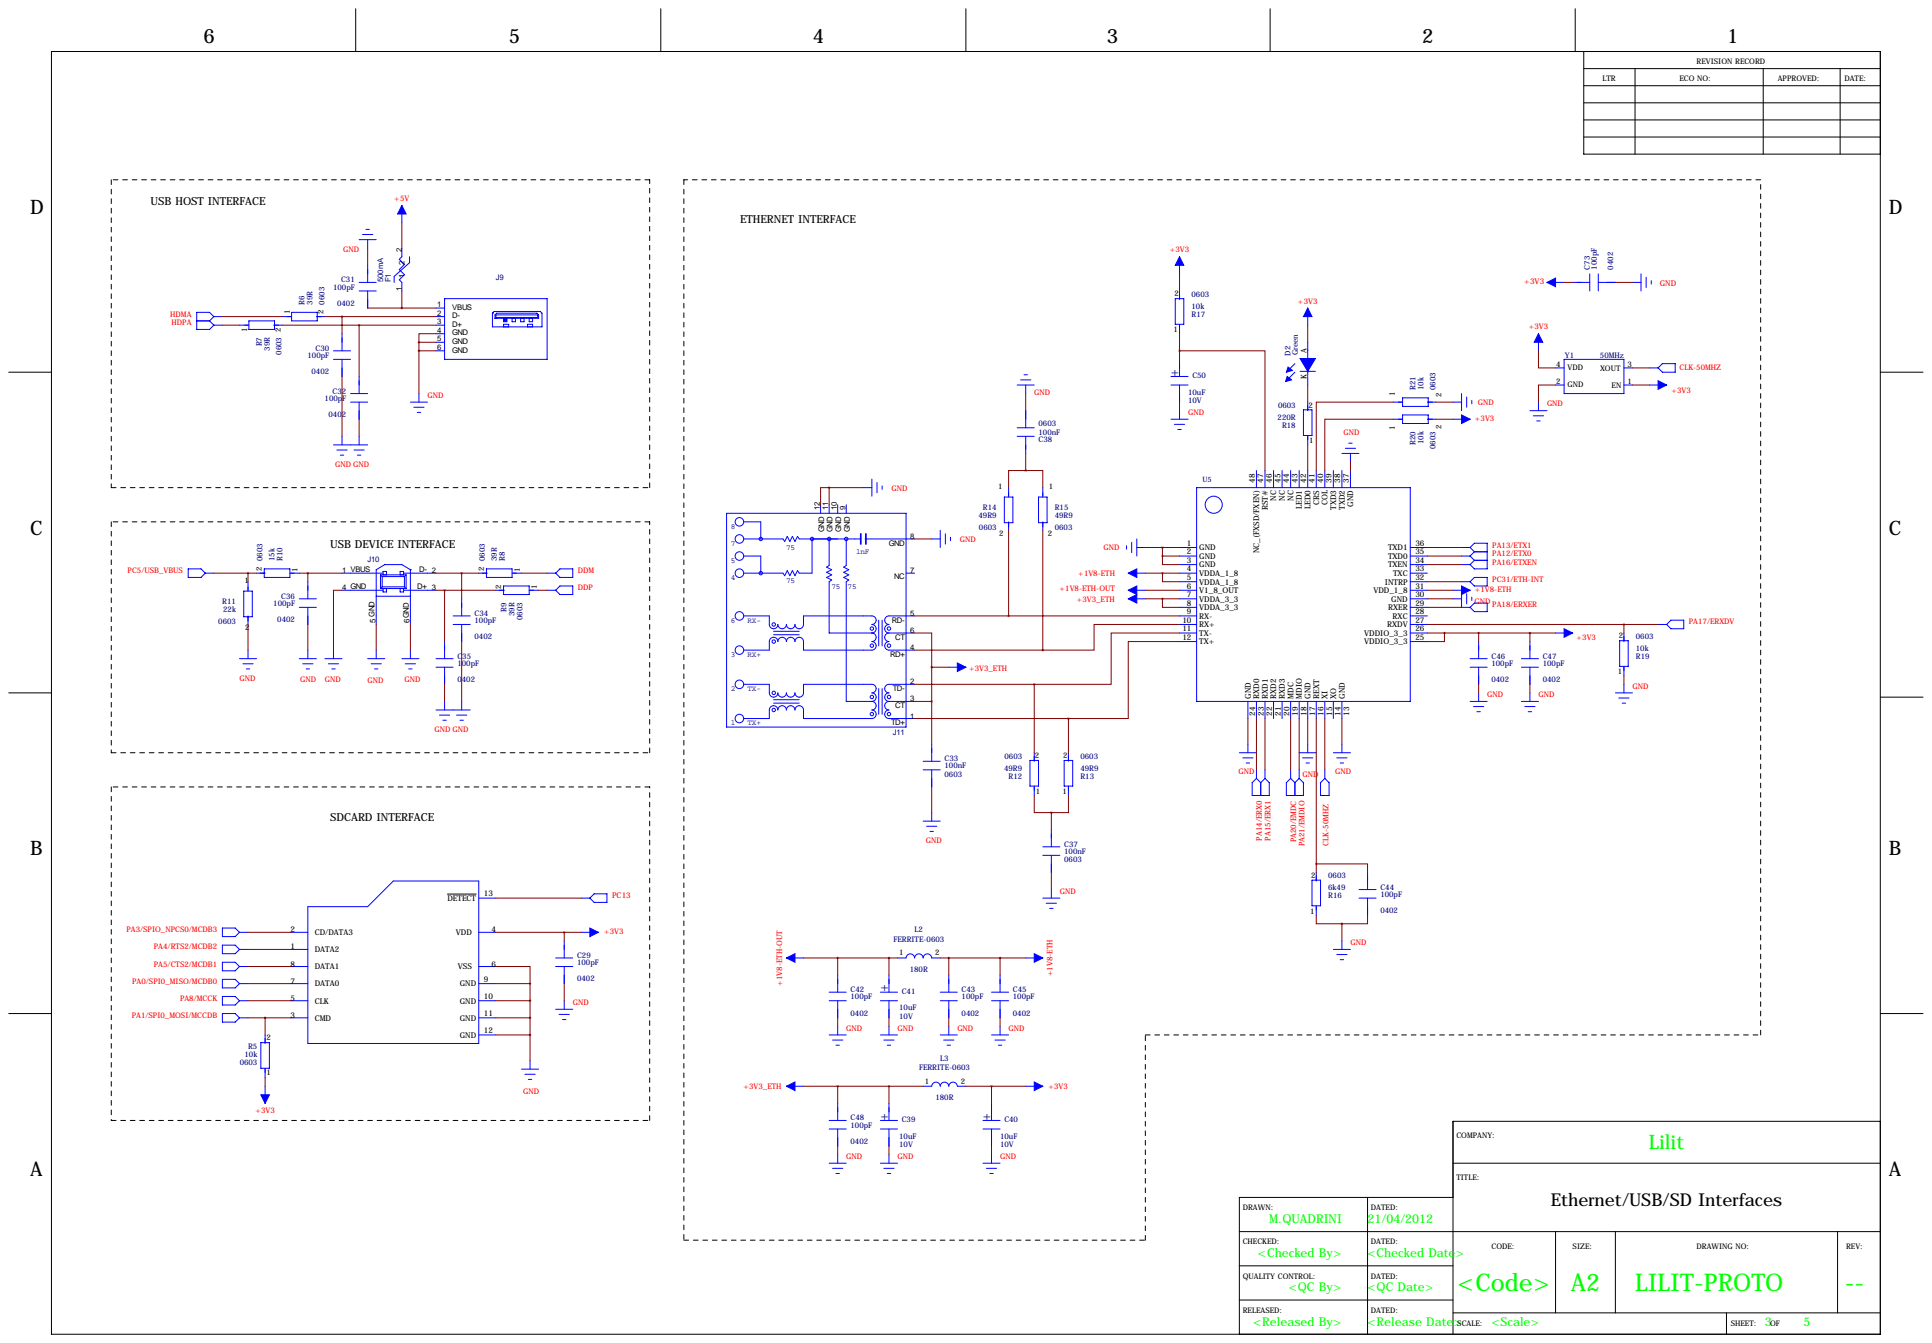
[picture p12: page 3]

2 | 35
3 | 34

Ethernet/USB/SD Interfaces

DRAWN: M.QUADRINI | DATED: 21/04/2012

CHECKED: <Checked By> | DATED: <Checked Date> | CODE: | SIZE: | DRAWING NO: | REV:

D

D

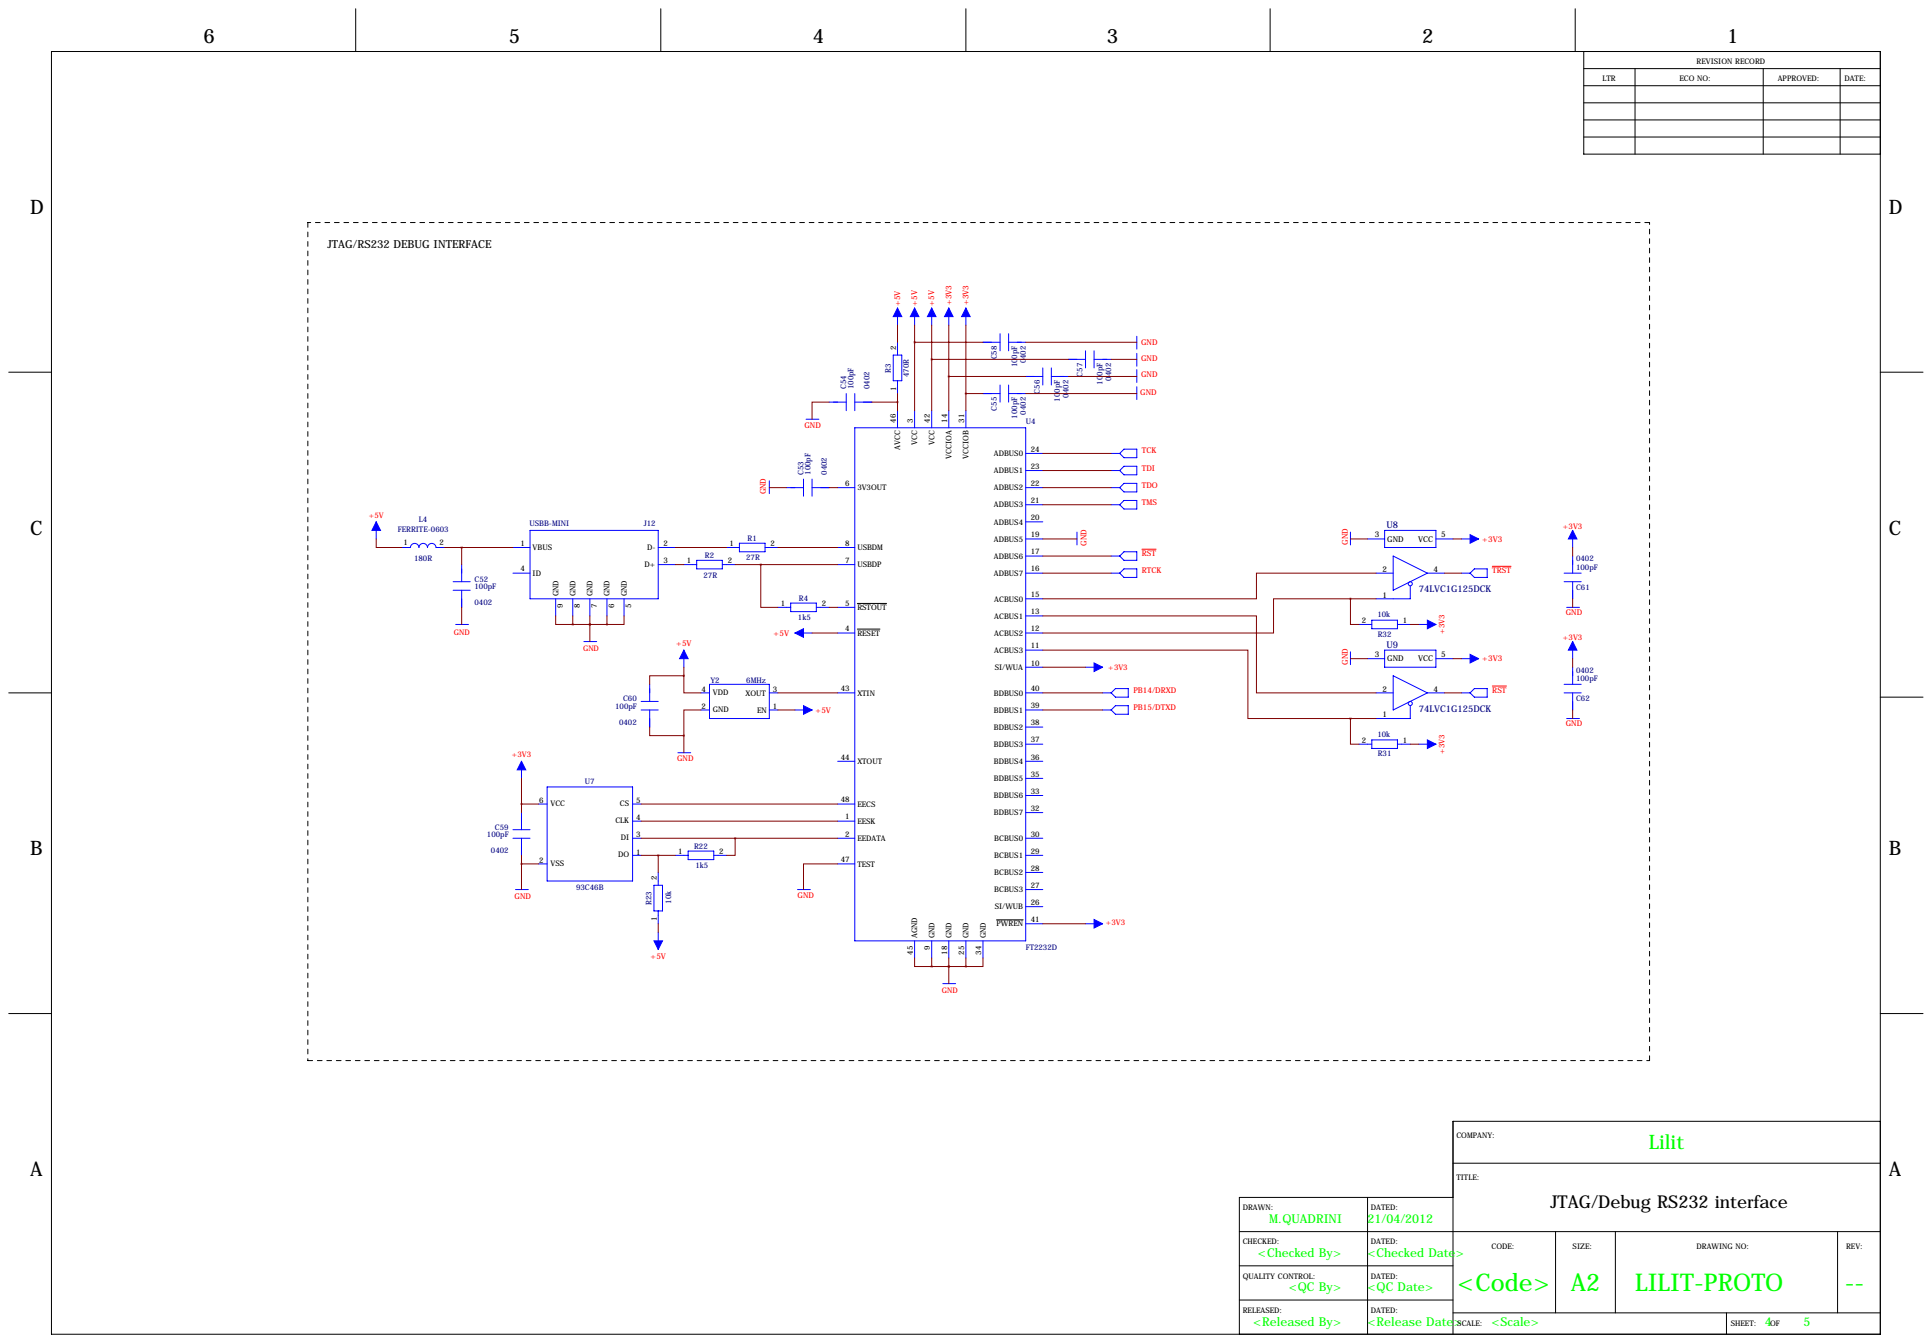
[picture p13: page 4]

DRAWN: M.QUADRINI | DATED: 21/04/2012

CHECKED: <Checked By> | DATED: <Checked Date> | CODE: | SIZE: | DRAWING NO: | REV:

D

D

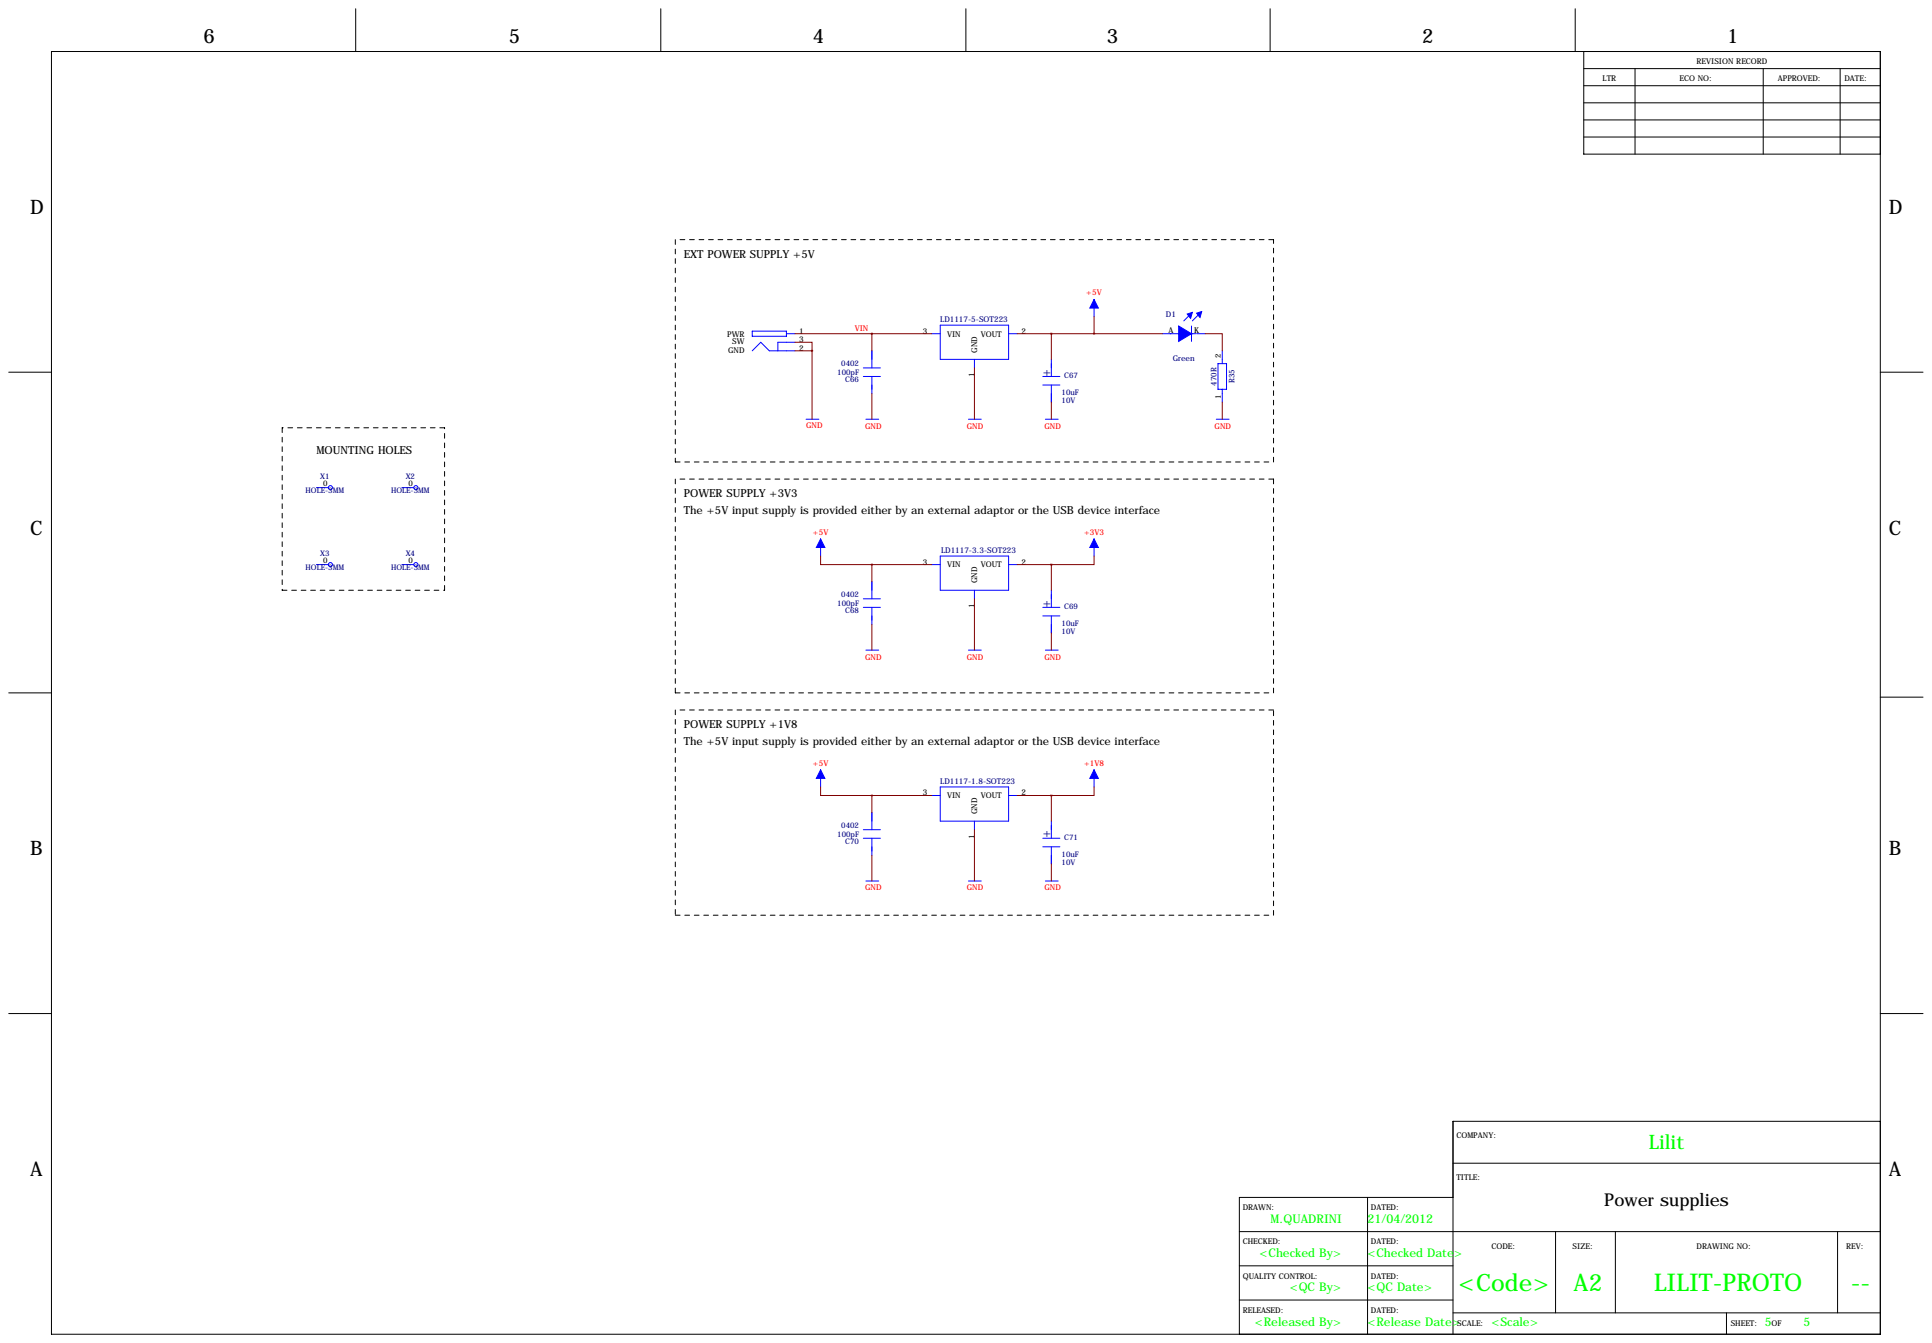
[picture p14: page 5]

POWER SUPPLY +3V3
The +5V input supply is provided either by an external adaptor or the USB device interface

POWER SUPPLY +1V8

DRAWN: M.QUADRINI | DATED: 21/04/2012
CHECKED: <Checked By> | DATED: <Checked Date> | CODE: <Code> | SIZE: A2 | DRAWING NO: LILIT-PROTO | REV: --
