lilith-project/lilith-hw-design/(list of files, drawings)

Other design files:
Proof of concept/Layout/Lilith-POC.pcb
Proof of concept/Layout/Lilith-POC_Layout.pcb
