lilith-project/lilith-hw-design/(commit log)

2012-01-14 Initial commit of lilith-dev repository
    [AT91SAM9XE-EK_A.sch, AT91SAM9XE-EK_A_Logic0.sch, AT91SAM9XE-EK_A_Logic1.sch, AT91SAM9XE-EK_A_Logic2.sch, AT91SAM9XE-EK_A_Logic3.sch, AT91SAM9XE-EK_A_Logic4.sch, AT91SAM9XE-EK_A_Logic5.sch, AT91SAM9XE-EK_A_Logic6.sch]
2012-01-14 Added HW/Libraries directory containing CAD software components libraries
2012-01-16 - Library update (missing files) - Minor changes to design files
    [Lilith-POC.pcb, Lilith-POC.sch, _Logic0.sch]
2012-01-16 - Added polarized capacitor, ferrite bead to library - PHY controller schematic work
2012-01-18 Unindexed large or out of scope files
    [AT91SAM9XE-EK_A.sch, AT91SAM9XE-EK_A_Logic0.sch, AT91SAM9XE-EK_A_Logic1.sch, AT91SAM9XE-EK_A_Logic2.sch, AT91SAM9XE-EK_A_Logic3.sch, AT91SAM9XE-EK_A_Logic4.sch, AT91SAM9XE-EK_A_Logic5.sch, AT91SAM9XE-EK_A_Logic6.sch]
2012-01-18 initial commit for github repo
    [Lilith-POC.sch]
2012-01-18 directory structure cleanup
    [Lilith-POC.pcb, Lilith-POC.sch]
2012-01-18 Ethernet PHY partly designed
    [Lilith-POC.pcb, Lilith-POC.sch]
2012-01-18 Ethernet PHY design update
    [Lilith-POC.pcb, Lilith-POC.sch]
2012-03-07 * Added Microchip library for MCP3008 ADC * Replaced MAX11602 ADC by MCP3008 (cheaper and multiple devices can coexist on the bus) * Added on ADC => increased analog inputs to 16 instead of 8 * Decre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
    [Lilith-POC.sch, Lilith-POC_Layout.pcb]
2012-03-10 * Created FT2232D, mini USB, 93C46 eeprom and micro push button parts\n* Added JTAG/Serial debug interface\n* Started MCU configuration
2012-03-11 Missing files from previous commit
    [Lilith-POC.sch, Lilith-POC_Layout.pcb]
2012-03-11 Created 74LVC1G125 part and completed debug interface
    [Lilith-POC.sch]
2012-03-12 Replaced SD with uSD connector and completed arduino I/O wiring
    [Lilith-POC.pcb, Lilith-POC.sch, Lilith-POC_Layout.pcb]
2012-03-12 Created uSD connector part
2012-03-14 Layout done for current schematic status. No routing done yet, a routing-test to be done
    [Lilith-POC.pcb, Lilith-POC.sch, Lilith-POC_Layout.pcb]
2012-03-14 Routing done for test. 100% routed but still power supply to be designed.
    [Lilith-POC.pcb, Lilith-POC.sch, Lilith-POC_Layout.pcb]
2012-03-27 First full-featured schematic/routing for review
    [Lilith-POC.pcb, Lilith-POC.sch, Lilith-POC_Layout.pcb]
2012-03-27 Created ST library and LD1117 regulators
2012-03-28 Minor routing updates: bigger power traces width, via stitching for GND planes, assembly layer cleaned-up.
    [Lilith-POC.pcb, Lilith-POC.sch, Lilith-POC_Layout.pcb]
2012-04-09 After J.Rouviere review: Fix on SDRAM wiring, added user leds, added missing arduino connectors and added SD card detect signal.
    [Lilith-POC.pcb, Lilith-POC.sch, Lilith-POC_Layout.pcb]
2012-04-09 Routing updated to implement the latest fixes
    [Lilith-POC.pcb, Lilith-POC.sch, Lilith-POC_Layout.pcb]
2012-04-14 Minor layout updates (mainly silkscreen)
    [Lilith-POC.pcb, Lilith-POC.sch, Lilith-POC_Layout.pcb]
2012-04-15 Silkscreen update + Minor PCB fixes
    [Lilith-POC.pcb, Lilith-POC.sch, Lilith-POC_Layout.pcb]
2012-04-15 PDF update
    [Lilith-POC.pcb]
2012-04-16 Layout update: silkscreen top & bottom
    [Lilith-POC.pcb, Lilith-POC.sch, Lilith-POC_Layout.pcb]
2012-04-16 Layout minor fixes, silkscreen update, Bill of material generated.
    [Lilith-POC.pcb, Lilith-POC.sch, Lilith-POC_BOM.xls, Lilith-POC_Layout.pcb]
2012-04-17 Schematics updated to add a 'category' attribute to each component in order to sort them by feature in the bill of material.
    [Lilith-POC.sch, Lilith-POC_BOM.xls]
2012-04-17 Passed the reset micro-switch to category JTAG/RS232 Debug
    [Lilith-POC.sch, Lilith-POC_BOM.xls]
2012-05-06 Manufacturing documents: Gerber, Assembly & Supplying bill of materials and Colorized soldering sheets
    [Lilith-POC.pcb, Lilith-POC.sch, Lilith-POC_BOM.xls, Lilith-POC_Layout.pcb]
